lupto/ember-pcb/README.md

# EMBER PCB

This is the PCB for interfacing the EMBER macro with FPGA, power supplies, probing, and power measurement.
