lupto/ember-pcb/checklists/schematic-checklist-akashl.md

# Schematic review checklist

## General

* [x] CAD ERC 100% clean. If some errors are invalid due to toolchain quirks, each exception must be inspected and signed
off as invalid.
* [ ] Verify pin numbers of all schematic symbols against datasheet or external interface specification document (if not yet board proven).
  * [ ] Confirm FMC pins are done correctly
  * [ ] Confirm EMBER pins are oriented correctly
  * [ ] Confirm EMBER pins are mapped correctly to package
  * [ ] Confirm EMBER pins are mapped correctly to socket
  * [ ] Confirm all 256 EMBER pins are routed
* [x] Schematic symbol matches chosen component package
* [x] Thermal pads are connected to correct power rail (may not always be ground)
* [x] Debug interfaces are not power gated in sleep mode

## Passive components
* [ ] Power/voltage/tolerance ratings specified as required
  * [ ] Regulators work up to 500 mA
  * [ ] Switches are rated for up to 500 mA
  * [ ] Capacitors are rated for >3.3V
  * [ ] Ferrite beads are rated for >3.3V
* [x] Ceramic capacitors appropriately de-rated for C/V curve
  * [x] Using the setup from TCAM board
* [x] Polarized components specified in schematic if using electrolytic caps etc.

## Power supply

### System power input

* [x] Fusing and/or reverse voltage protection at system power inlet
* [x] Check total input capacitance and add inrush limiter if needed

### Regulators

* [x] Under/overvoltage protection configured correctly if used
  * [x] Implemented in regulators and at FPGA and EMBER macro
* [x] Verify estimated power usage per rail against regulator rating
* [x] Current-sense resistors on power rails after regulator output caps, not in switching loop
  * [x] Done on power measurement daughter board...
* [ ] Remote sense used on low voltage or high current rails
* [ ] Linear regulators and voltage reference ICs are stable with selected output cap ESR
* [ ] Confirm power rail sequencing against device datasheets

### Decoupling
* [x] Decoupling present for all ICs
* [ ] Decoupling meets/exceeds vendor recommendations if specified
* [x] Bulk decoupling present at PSU

### General
* [x] All power inputs fed by correct voltage
* [x] Check high-power discrete semiconductors and passives to confirm they can handle expected load
* [x] Analog rails filtered/isolated from digital circuitry as needed
  * [x] Separate planes should help

## Signals

### Digital

* [x] Signals are correct logic level for input pin
  * [x] All signals will be at FPGA setting
* [x] Pullups on all open-drain outputs
* [x] Pulldowns on all PECL outputs
* [x] Termination on all high-speed signals
* [x] AC coupling caps on gigabit transceivers
* [x] TX/RX paired correctly for UART, SPI, MGT, etc
* [x] Differential pair polarity / pairing correct
* [x] Active high/low enable signal polarity correct
* [x] I/O banking rules met on FPGAs etc
* [x] When using auto-sensing level shifters, ensure the intended receiver doesn't have a pullup/down

### Analog

* [x] RC time constant for attenuators sane given ADC sampling frequency
* [x] Verify frequency response of RF components across entire operating range. Don't assume a "1-100 MHz" amplifier has the
same gain across the whole range.
* [x] Verify polarity of op-amp feedback

### Clocks

* [x] All oscillators meet required jitter / frequency tolerance. Be extra cautious with MEMS oscillators as these tend to have higher jitter.
* [x] Correct load caps provided for discrete crystals
* [x] Crystals only used if IC has an integrated crystal driver
* [x] Banking / clock capable input rules met for clocks going to FPGAs
    * [x] Xilinx FPGAs: single ended clocks use _P half of differential pairs
    * [x] If possible, create dummy design with all clocks and other key signals and verify it P&R's properly

### Strap/init pins
* [x] Pullup/pulldowns on all signals that need defined state at boot
* [x] Strap pins connected to correct rail for desired state
  * [x] DIP switches are strapped to io_pwr
* [x] JTAG/ICSP connector provided for all programmable devices
* [x] Config/boot flash provided for all FPGAs or MPUs without internal flash
* [x] Reference resistors correct value and reference rail

### External interface protection

* [x] Power outputs (USB etc) current limited
  * [x] Regulators do this
* [x] ESD protection on data lines going off board
  * [x] Exist in EMBER and FPGA

### Debugging / reworkability

* [x] Use 0-ohm resistors vs direct hard-wiring for strap pins when possible
* [x] Provide multiple ground clips/points for scope probes
  * [x] Available on power header and analog header
* [x] Dedicated ground in close proximity to analog test points
* [x] Test points on all power rails
  * [x] Accessible through power headers
* [x] Test points on interesting signals which may need probing for bringup/debug
  * [x] Heartbeat
  * [x] All EMBER signals can be probed on bottom through socket

## Thermal

* [x] Power estimates for all large / high power ICs
  * [x] EMBER should never exceed 100 mA
* [x] Thermal calculations for all large / high power ICs
* [x] Specify heatsinks as needed
