lupto/ember-pcb/bom/EMBER_PCB.digikey.bom.xlsx

Country of Origin may be different at time of shipment.
The HTSUS and ECCN information shown is for informational purposes only and is not a representation or warranty as to the accuracy or reliability of these classifications. All information is provided "as is" and is subject to change without notice. Any use made of the information provided is without recourse to Digi-Key and at the user's risk.
Index | Manufacturer Part Number | Manufacturer Name | Description | Availability | Stock Status | Attrition % | Requested Quantity 1 | Pack Quantity 1 | Pack Type 1 | Digi-Key Part Number 1 | Unit Price 1 | Extended Price 1 | Minimum Order Quantity 1 | Customer Reference | Requested Part Number | Lead Weeks | Datasheet | Reference Designator | US Import Tariff | Note | Part Status | RoHS Status | ECCN | HTSUS | Country of Origin | Environmental Information | Original Part numbers | Image
1 | 28C0236-0JW-10 | Laird-Signal Integrity Products | FERRITE BEAD 998 OHM RADIAL 1LN | 133,536 | In Stock |  | 2 | 2 | Bulk | 240-2493-ND | 0.90000 | $1.80 | 1 |  | 240-2493-ND | 22 | https://media.digikey.com/pdf/Data%20Sheets/Laird%20Technologies/EMI_Filtering_and_RF_Inductors.pdf | FB1, FB2 | N/A |  | Active | ROHS3 Compliant | EAR99 | 8548.00.0000 | China |  | 240-2493-ND | https://media.digikey.com/photos/Steward%20Photos/28C0236-0JW-10.jpg
2 | 441-PRS21001-12 | Aries Electronics | CONN SOCKET PGA ZIF GOLD | 0 | Normally Stocking |  | 1 | 1 | Bulk | A318-ND | 164.97000 | $164.97 | 1 |  | A318-ND | 6 | https://www.arieselec.com/wp-content/uploads/2020/12/10004-pga-zif-test-and-burn-in-socket.pdf | U1 | N/A |  | Active | ROHS3 Compliant | EAR99 | 8536.69.4040 | United States | https://www.arieselec.com/wp-content/uploads/2020/05/RoHS-3-Declaration.pdf|https://www.arieselec.com/wp-content/uploads/2021/03/REACH-211-Compliance-Statement.pdf | A318-ND | https://media.digikey.com/photos/Aries/441-PRS21001-12.jpg
3 | LP5912-0.9DRVT | Texas Instruments | IC REG LINEAR 0.9V 500MA 6WSON | 708 | In Stock |  | 1 | 1 | Cut Tape (CT) | 296-44154-1-ND | 1.60000 | $1.60 | 1 |  | 296-44154-1-ND | 6 | http://www.ti.com/general/docs/suppproductinfo.tsp?distId=10 | U2 | N/A |  | Active | ROHS3 Compliant | EAR99 | 8542.39.0001 | Philippines |  | 296-44154-1-ND | https://media.digikey.com/Renders/Texas%20Instr%20Renders/296~4222173~DRV~6.jpg
4 | LP5912-1.1DRVT | Texas Instruments | IC REG LINEAR 1.1V 500MA 6WSON | 694 | In Stock |  | 1 | 1 | Cut Tape (CT) | 296-46644-1-ND | 1.60000 | $1.60 | 1 |  | 296-46644-1-ND | 12 | http://www.ti.com/general/docs/suppproductinfo.tsp?distId=10 | U3 | N/A |  | Active | ROHS3 Compliant | EAR99 | 8542.39.0001 | Philippines |  | 296-46644-1-ND | https://media.digikey.com/Renders/Texas%20Instr%20Renders/296~4222173~DRV~6.jpg
5 | LP5912-2.5DRVT | Texas Instruments | IC REG LINEAR 2.5V 500MA 6WSON | 266 | In Stock |  | 1 | 1 | Cut Tape (CT) | 296-52223-1-ND | 1.60000 | $1.60 | 1 |  | 296-52223-1-ND | 6 | http://www.ti.com/general/docs/suppproductinfo.tsp?distId=10 | U4 | May apply on shipments to the U.S. |  | Active | ROHS3 Compliant | EAR99 | 8542.39.0001 | China |  | 296-52223-1-ND | https://media.digikey.com/Renders/Texas%20Instr%20Renders/296~4222173~DRV~6.jpg
6 | LT Q39E-Q1OO-25-1 | OSRAM Opto (ams OSRAM) | LED GREEN DIFFUSED 0603 SMD | 17,350 | In Stock |  | 1 | 1 | Cut Tape (CT) | 475-3441-1-ND | 0.43000 | $0.43 | 1 |  | 475-3441-1-ND | 14 | https://dammedia.osram.info/media/resource/hires/osram-dam-2493475/LT%20Q39E.pdf | D1 | N/A |  | Active | ROHS3 Compliant | EAR99 | 8541.41.0000 | Taiwan |  | 475-3441-1-ND | https://media.digikey.com/Renders/Osram%20Opto%20Renders/LB-Q39E.jpg
7 | ASP-134602-01 | Samtec Inc. | CONN ARRAY PLUG 400POS SMD GOLD | 2,131 | In Stock |  | 1 | 1 | Cut Tape (CT) | 612-ASP-134602-01CT-ND | 29.88000 | $29.88 | 1 |  | 612-ASP-134602-01CT-ND | 11 | http://suddendocs.samtec.com/prints/asp-134602-01.pdf | J1 | N/A |  | Active | ROHS3 Compliant | EAR99 | 8536.69.4040 | Costa Rica |  | 612-ASP-134602-01CT-ND | https://media.digikey.com/Photos/Samtec%20Photos/ASP-134602-01_TOP.JPG
8 | 0732512200 | Molex | CONN SMA JACK R/A 50 OHM PCB | 26,937 | In Stock |  | 2 | 2 | Bulk | WM9352-ND | 6.88000 | $13.76 | 1 |  | WM9352-ND | 8 | https://www.molex.com/pdm_docs/sd/732512200_sd.pdf | J2, J5 | N/A |  | Active | ROHS3 Compliant | EAR99 | 8536.69.4010 | Taiwan | https://www.molex.com/datasheets/rohspdf/0732512200_rohs.pdf | WM9352-ND | https://media.digikey.com/Photos/Molex/0732512200.jpg
9 | PH2-12-UA | Adam Tech | CONN HEADER VERT 12POS 2.54MM | 19,939 | In Stock |  | 1 | 1 | Bag | 2057-PH2-12-UA-ND | 0.20000 | $0.20 | 1 |  | 2057-PH2-12-UA-ND | 10 | https://app.adam-tech.com/products/download/data_sheet/202065/ph2-xx-ua-data-sheet.pdf | J3 | N/A |  | Active | ROHS3 Compliant | EAR99 | 8536.69.4040 | Taiwan |  | 2057-PH2-12-UA-ND | https://media.digikey.com/Renders/Adam-Tech%20Renders/PH2-xx-UA.jpg
10 | PH1-07-UA | Adam Tech | CONN HEADER VERT 7POS 2.54MM | 23,741 | In Stock |  | 1 | 1 | Bag | 2057-PH1-07-UA-ND | 0.15000 | $0.15 | 1 |  | 2057-PH1-07-UA-ND | 10 | https://app.adam-tech.com/products/download/data_sheet/201605/ph1-xx-ua-data-sheet.pdf | J4 | N/A |  | Active | ROHS3 Compliant | EAR99 | 8536.69.4040 | Taiwan |  | 2057-PH1-07-UA-ND | https://media.digikey.com/Renders/Adam-Tech%20Renders/PH1-xx-UA.jpg
11 | AC0603JR-101KL | YAGEO | RESISTOR SMD | 58,836 | In Stock |  | 1 | 1 | Cut Tape (CT) | 13-AC0603JR-101KLCT-ND | 0.10000 | $0.10 | 1 |  | 13-AC0603JR-101KLCT-ND | 20 | https://www.yageo.com/upload/media/product/productsearch/datasheet/rchip/PYu-AC_51_RoHS_L_9.pdf | R1 | N/A |  | Active | ROHS3 Compliant | EAR99 | 8533.21.0030 | Taiwan |  | 13-AC0603JR-101KLCT-ND | https://media.digikey.com/Renders/Yageo%20Renders/AC-Series--SMD-Chip-Resistor.jpg
12 | RT0603DRE10100KL | YAGEO | CHIP RESISTOR THIN FLIM HIGH PRE | 9,069 | In Stock |  | 2 | 2 | Cut Tape (CT) | 13-RT0603DRE10100KLCT-ND | 0.11000 | $0.22 | 1 |  | 13-RT0603DRE10100KLCT-ND | 22 | https://www.yageo.com/upload/media/product/productsearch/datasheet/rchip/PYu-RT_1-to-0.01_RoHS_L_13.pdf | R2, R3 | N/A |  | Active | ROHS3 Compliant | EAR99 | 8533.21.0030 | Taiwan |  | 13-RT0603DRE10100KLCT-ND | https://media.digikey.com/Renders/Yageo%20Renders/RT-Series-Chip-Resistor.jpg
13 | PCM13SMTR | C&K | SWITCH SLIDE SP3T 300MA 6V | 8,339 | In Stock |  | 2 | 2 | Cut Tape (CT) | 401-2017-1-ND | 1.02000 | $2.04 | 1 |  | 401-2017-1-ND | 9 | https://www.ckswitches.com/media/1424/pcm.pdf | SW1, SW2 | May apply on shipments to the U.S. |  | Active | ROHS3 Compliant | EAR99 | 8536.50.9050 | China | https://www.ckswitches.com/media/3448/rohs-reach-compliance-certificate.pdf | 401-2017-1-ND | https://media.digikey.com/Photos/CK%20Comp%20Photos/PCM13SMTR.JPG
14 | A6S-2101-H | Omron Electronics Inc-EMC Div | SWITCH SLIDE DIP SPST 25MA 24V | 657 | In Stock |  | 1 | 1 | Bulk | Z5188-ND | 2.12000 | $2.12 | 1 |  | Z5188-ND | 27 | https://omronfs.omron.com/en_US/ecb/products/pdf/en-a6s.pdf | SW3 | May apply on shipments to the U.S. |  | Active | RoHS Compliant | EAR99 | 8536.50.9065 | China |  | Z5188-ND | https://media.digikey.com/Photos/Omron%20Elect%20Photos/A6S-2101-H.jpg
15 | T495B226K010ATE500 | KEMET | CAP TANT 22UF 10% 10V 1411 | 3,457 | In Stock |  | 4 | 4 | Cut Tape (CT) | 399-18339-1-ND | 1.57000 | $6.28 | 1 |  | 399-18339-1-ND | 44 | https://api.kemet.com/component-edge/download/datasheet/T495B226K010ATE500.pdf | C1, C3, C6, C8 | N/A |  | Active | ROHS3 Compliant | EAR99 | 8532.21.0050 | Mexico |  | 399-18339-1-ND | https://media.digikey.com/Photos/Kemet%20Photos/MFG_T495-Series.jpg
16 | C3225X7T2J104K160AE | TDK Corporation | CAP CER 0.1UF 630V X7T 1210 | 19,884 | In Stock |  | 4 | 4 | Cut Tape (CT) | 445-8907-1-ND | 0.65000 | $2.60 | 1 |  | 445-8907-1-ND | 28 | https://product.tdk.com/system/files/dam/doc/product/capacitor/ceramic/mlcc/catalog/mlcc_commercial_soft_en.pdf | C2, C5, C7, C10 | N/A |  | Active | ROHS3 Compliant | EAR99 | 8532.24.0020 | Japan | https://product.tdk.com/system/files/dam/doc/product/capacitor/ceramic/mlcc/rohs/mlccrohs_commercial_soft_en.pdf|https://product.tdk.com/en/environment/index.html | 445-8907-1-ND | https://media.digikey.com/Renders/TDK%20Renders/1210-(3225-Metric)-2,80mm-C-Series.jpg
17 | T494B106K025AT | KEMET | CAP TANT 10UF 10% 25V 1411 | 15,393 | In Stock |  | 2 | 2 | Cut Tape (CT) | 399-5126-1-ND | 1.48000 | $2.96 | 1 |  | 399-5126-1-ND | 56 | https://api.kemet.com/component-edge/download/datasheet/T494B106K025AT.pdf | C4, C9 | N/A |  | Active | ROHS3 Compliant | EAR99 | 8532.21.0050 | Mexico |  | 399-5126-1-ND | https://media.digikey.com/photos/Kemet%20Photos/T494B685K016AT.JPG
