lupto/ember-pcb/bom/Sierra-BOM-Sample-and-Demo.xls

This is a sample BOM for Sierra Circuits' online BOM pricing system. Please use this preferred format for your BOM that you upload.
Note: DNI applies to whole row. If only some specific locations of a given ITEM are not to be installed, please create two rows for that item and mark one as DNI.
BOM: <Board Name Here>
Assembly Part Number/Revision:
Customer / Company Name:
Item # | Quantity per board | Manufacturer Part # | Do Not Install | Reference designators | Vendor (optional) | Vendor Part Number (optional) | Value (optional) | Size / Footprint (optional) | Part description/ specs (optional, but recommended) | Manfacturer (optional)
1 | 2 | T520L337M2R5ATE025 |  | C12,C15 | Digi-Key | 399-5134-1-ND | 330uF | C6032 | CAP TANT 330UF 2.5V 20% SMD | Kemet
2 | 2 | T520L337M2R5ATE025 | DNI | C16,C17 | Digi-Key | 399-5134-1-ND | 330uF | C6032 | CAP TANT 330UF 2.5V 20% SMD | Kemet
3 | 2 | RMCF0805FT2K40 |  | R19, R24 | Digi-Key | 541-2.40KCCT-ND |  |  | RES SMD 2.4K OHM 1% 1/8W 0805 | Vishay Dale
4 | 5 | C3225X7R1E106M | DNI | C65,C66,C67,C68,C119 | Mouser | 810-C3225X7R1E106M | 10uF | C1210 (3225 metric) | CAP CER 10uF 25V X7R 20% SMD 1210 | TDK
5 | 3 | C0805C103J5GACTU |  | C149,C151,C161 | Digi-Key | 399-7992-1-ND | 10nF | C0805 | CAP CER 10000PF 50V C0G/NP0 0805 | KEMET
6 | 3 | GRM32ER61A476KE20L |  | C167, C169, C141 | Digi-Key | 490-3887-1-ND | 47uF | C1210 (3225 metric) | CAP CER 47UF 10V X5R 1210 | Taiyo Yuden
7 | 5 | C0805F104K5RACTU |  | C159, C152, C162, C166, C168 | Digi-Key | 478-1395-1-ND | 0.1uF | C0805 | CAP CER 0.1UF 50V X7R 0805 | Yageo
8 | 1 | T495D477M006ATE045 |  | C153 | Digi-Key | 399-5220-1-ND | 470uF | C7343-31 | CAP TANTALUM 470UF 6.3V 0.045ohm ESR SMD | Kemet
9 | 2 | B540C-13-F |  | D1,D2 | Digi-Key | B540C-FDICT-ND | 40V 5A | SMC | DIODE SCHOTTKY 40V 5A SMC | Diodes Inc
10 | 12 | APHCM2012CGCK-F01 |  | D3,D4,D5,D6,D7,D8,D9,D10,D11,D12,D13,D14 | Digi-Key | 754-1094-1-ND | LED | LED0805 | LED 2X1.25MM LOPRO 570NM GRN SMD | Kingbright Corp
11 | 1 | 2-5177986-5 |  | J5 | Digi-Key | A35089CT-ND | CON120 | conn_2x60_th | CONN PLUG 120 POS VERT DUAL | TE Connectivity
12 | 6 | 961103-6404-AR |  | J6,J7,J8,J9,J15,J17 | Digi-Key | 3M9448-ND | CON3 | HDR1X3_TH | CONN HEADER VERT SGL 3POS GOLD | 3M
13 | 1 | 961102-6404-AR |  | J16 | Digi-Key | 3M9447-ND | JUMPER | HDR1X2TH | CONN HEADER VERT SGL 2POS GOLD | 3M
14 | 10 | GBC36SFBN-M30 |  | JP1-JP10 | Digi-Key | S1043E-36-ND | 1 PIN HEADER | HDR1x1 | 1 PIN HEADER; BREAK FROM 36 PIN STANDARD HEADER STRIP | Sullins
15 | 14 | CRCW080510K0FKEA |  | R8, R14, R16, R17, R25, R26, R27, R28, R29, R30, R31, R33, R34, R35 | Mouser | 71-CRCW0805-10K-E3 |  |  | Thick Film Resistors - SMD 1/8watt 10Kohms 1% 100ppm | Vishay
16 | 3 | MSS1048-103MLB |  | L4,L6,L7 | COILCRAFT | MSS1048-103MLB | 10uH | ind_Mss1048 | INDUCTOR POWER 10UH 4.0A SMD 26mOHM | COILCRAFT
17 | 1 | SRR1260-120M |  | L5 | Arrow | SRR1260-120M | 12uH | ind_Srr1260 | INDUCTOR POWER 12UH 5.0A SMD 23mOHM | BOURNS
18 | 1 | SRR6603-1R5ML |  | L8 | Digi-Key | SRR6603-1R5MLCT-ND | 1.5uH | ind_Srr6603 | INDUCTOR POWER 1.5UH 2.8A SMD 45mOHM | BOURNS
19 | 6 | ERJ-2GEJ271X |  | R1,R2,R3,R4,R5,R6 | Digi-Key | P270JCT-ND | 270R | R0402 | RES 270 OHM 1/10W 5% 0402 SMD | Panasonic
20 | 2 | ERJ-2GEJ331X |  | R7,R9 | Digi-Key | P330JCT-ND | 330 | R0402 | RES 330 OHM 1/10W 5% 0402 SMD | Panasonic
21 | 5 | ERJ-2GEJ472X |  | R10,R11,R21,R22,R23 | Digi-Key | P4.7KJCT-ND | 4.7K | R0402 | RES 4.7K OHM 1/10W 5% 0402 SMD | Panasonic
22 | 2 | ERJ-6ENF6192V |  | R15,R18 | Digi-Key | P61.9KCCT-ND | 61.9K | R0805 | RES 61.9K OHM 1/8W 1% 0805 SMD | Panasonic
23 | 1 | ERJ-6ENF1581V |  | X7 | Digi-Key | P1.58KCCT-ND | 1.58K | R0805 | RES 1.58K OHM 1/8W 1% 0805 SMD | Panasonic
24 | 1 | NVF2955T1G |  | Q1 | Digi-Key | NVF2955T1GOSCT-ND |  |  | MOSFET P-CH 60V 2.6A SOT223 | ON Semiconductor
25 | 1 | ERJ-6ENF2550V |  | R48 | Digi-Key | P255CCT-ND | 255 | R0805 | RES 255 OHM 1/8W 1% 0805 SMD | Panasonic
26 | 4 | ERJ-3GEY0R00V |  | R37,R45,R46,R47 | Digi-Key | P0.0GCT-ND | 0 | R0603 | RES ZERO OHM 1/10W 5% 0603 SMD | Panasonic
27 | 2 | SN74ALVC244NSR |  | U1,U7 | Digi-Key | 296-12863-1-ND | SN74ALVC244 | SOP-20 | IC BUFF/DVR TRI-ST OCTAL 20SOP | Texas Instruments
28 | 2 | LM22670TJE-ADJ/NOPB |  | U4,U5 | Digi-Key | LM22670TJE-ADJCT-ND | LM22670TJE-ADJ/NOPB | TO263-7 | IC REG SWITCH BUC 3A ADJ TO263-7 | Texas Instruments
29 | 1 | ERA-6AEB1402V |  | X2 | Digi-Key | P14KDACT-ND |  |  | RES SMD 14K OHM 0.1% 1/8W 0805 | Panasonic
END OF BOM
