lupto/ember-pcb/components/73251-2200.stp

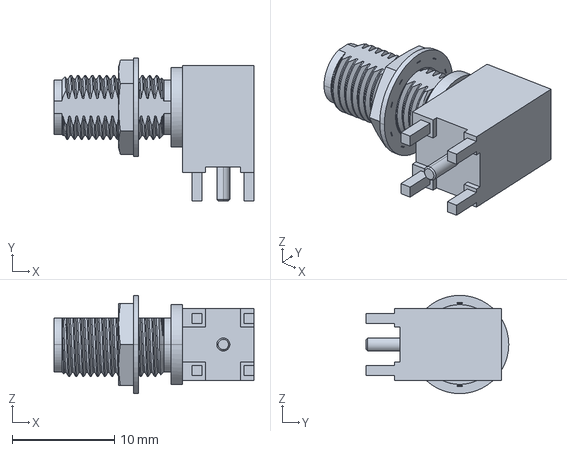
[picture p1: CAD file, 2022-12-14]
components/73251-2200.stp
19.5 x 13.9 x 9.60 mm
