lupto/ember-pcb/ember-pcb.kicad_pcb

## KiCad design ember-pcb.kicad_pcb (2022-12-09)

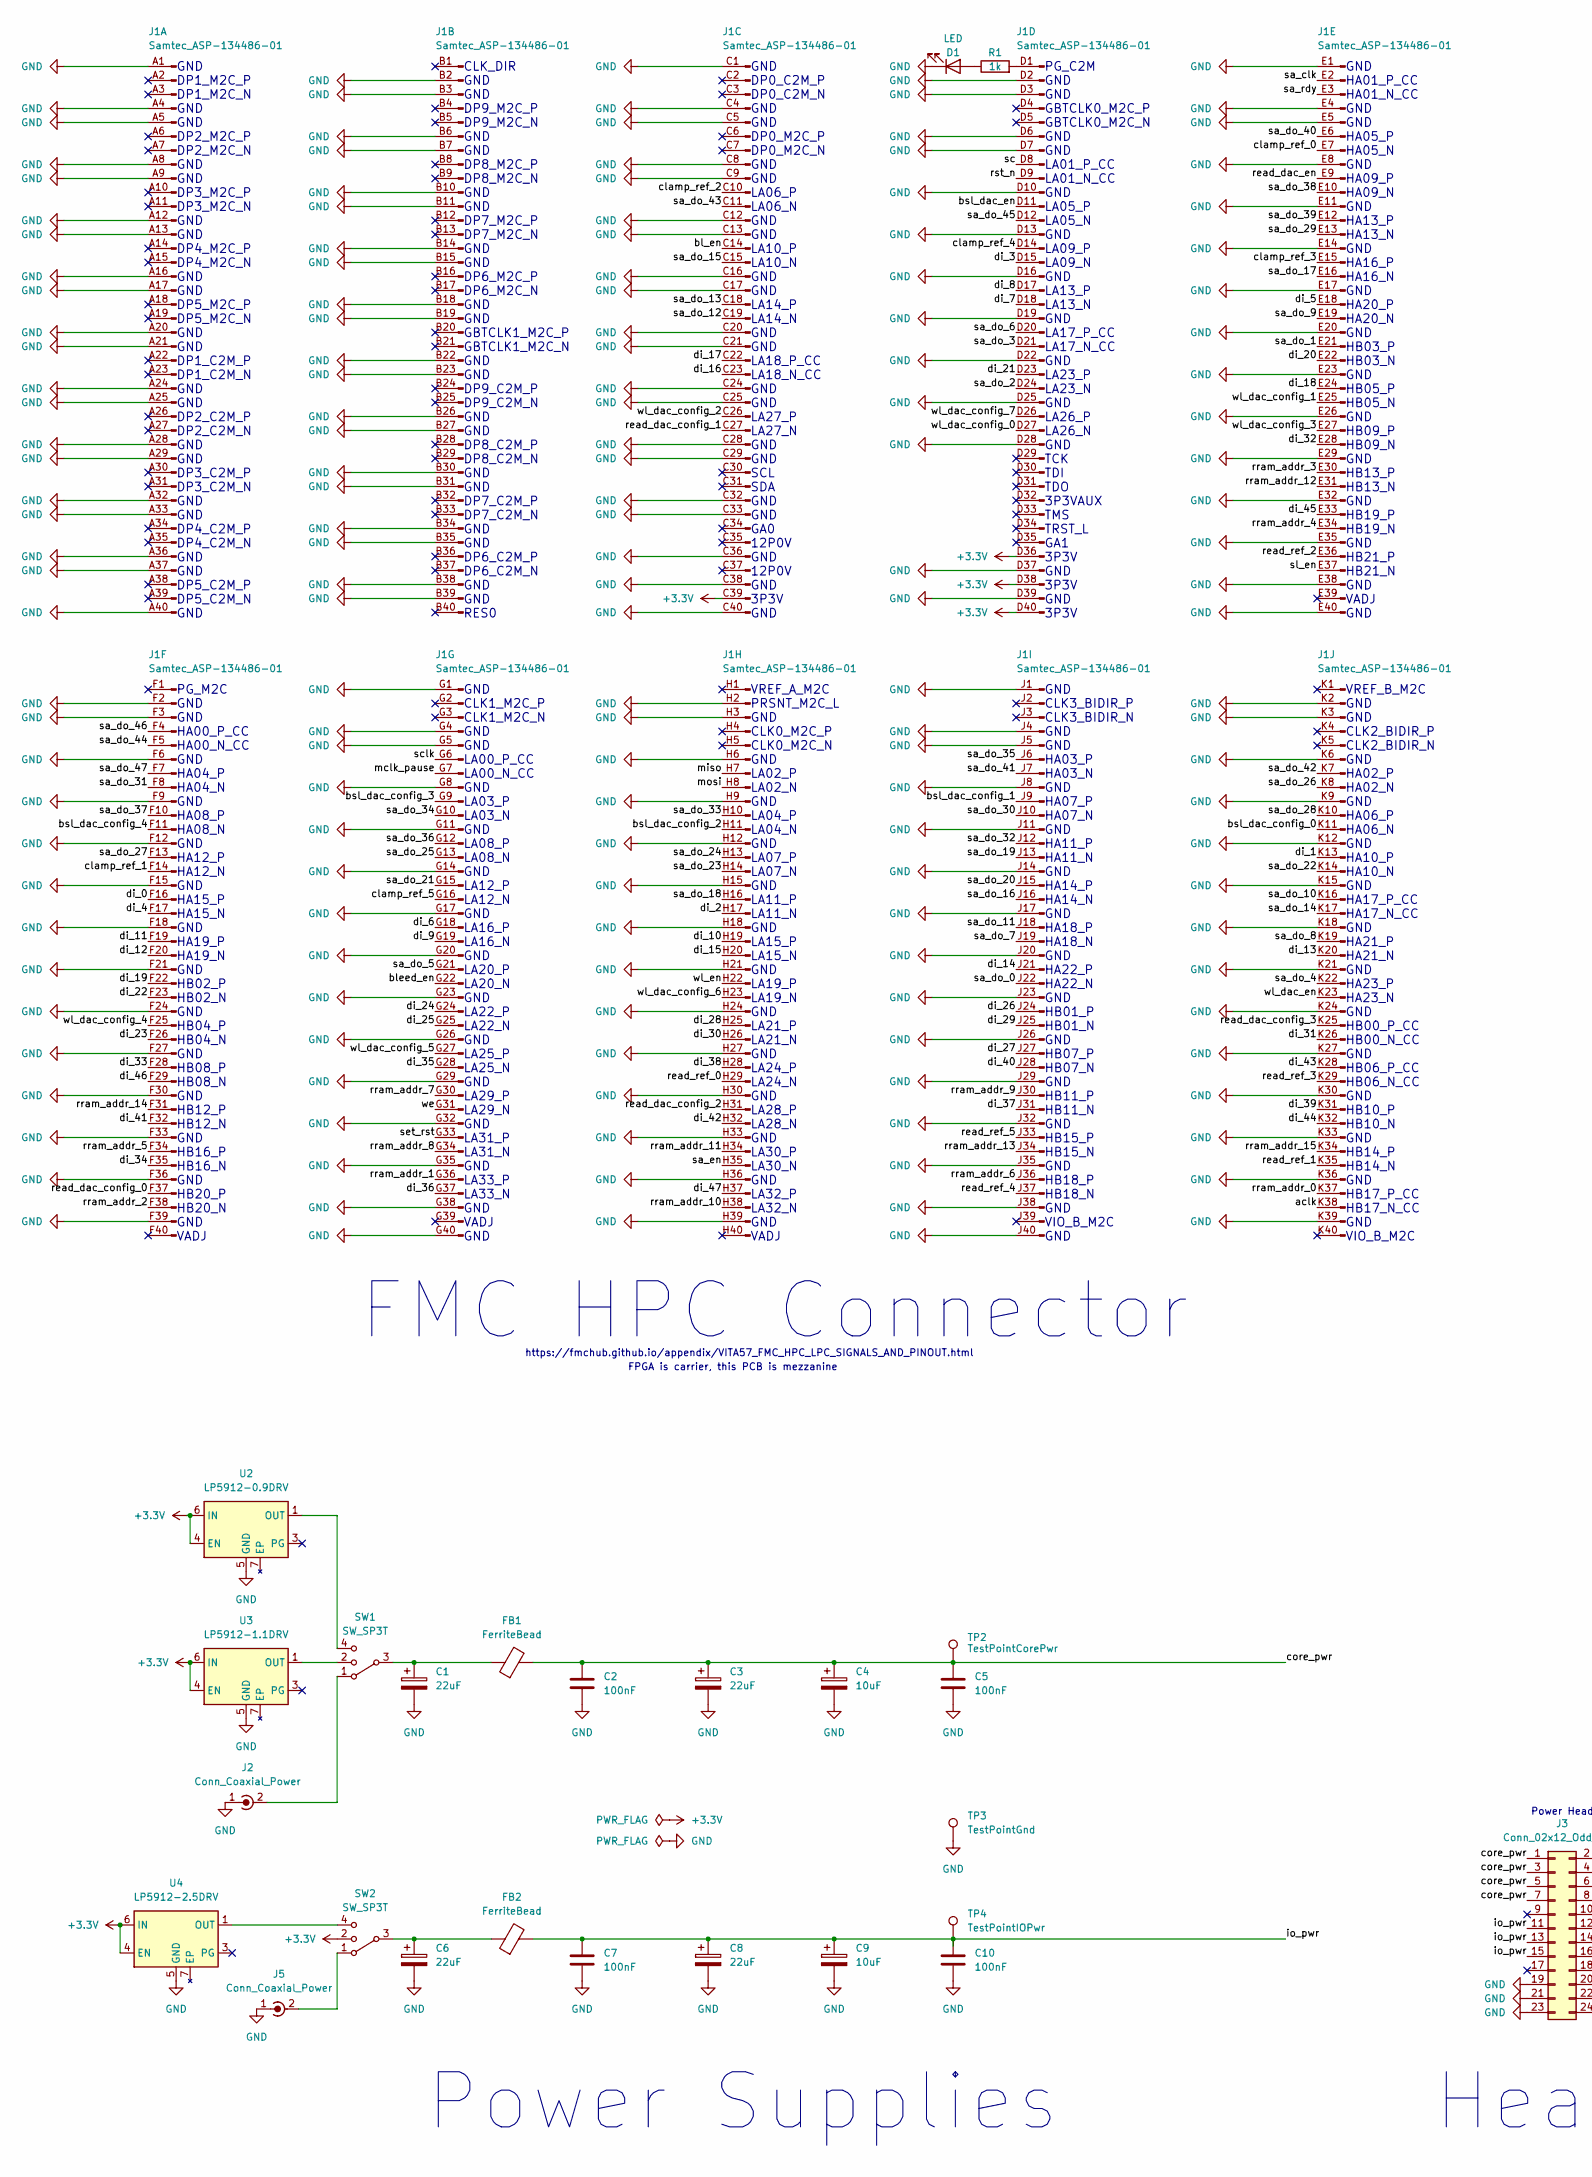
[picture p11: schematic ember-pcb.kicad_sch, EMBER PCB Schematic, part in row 1, column 1]

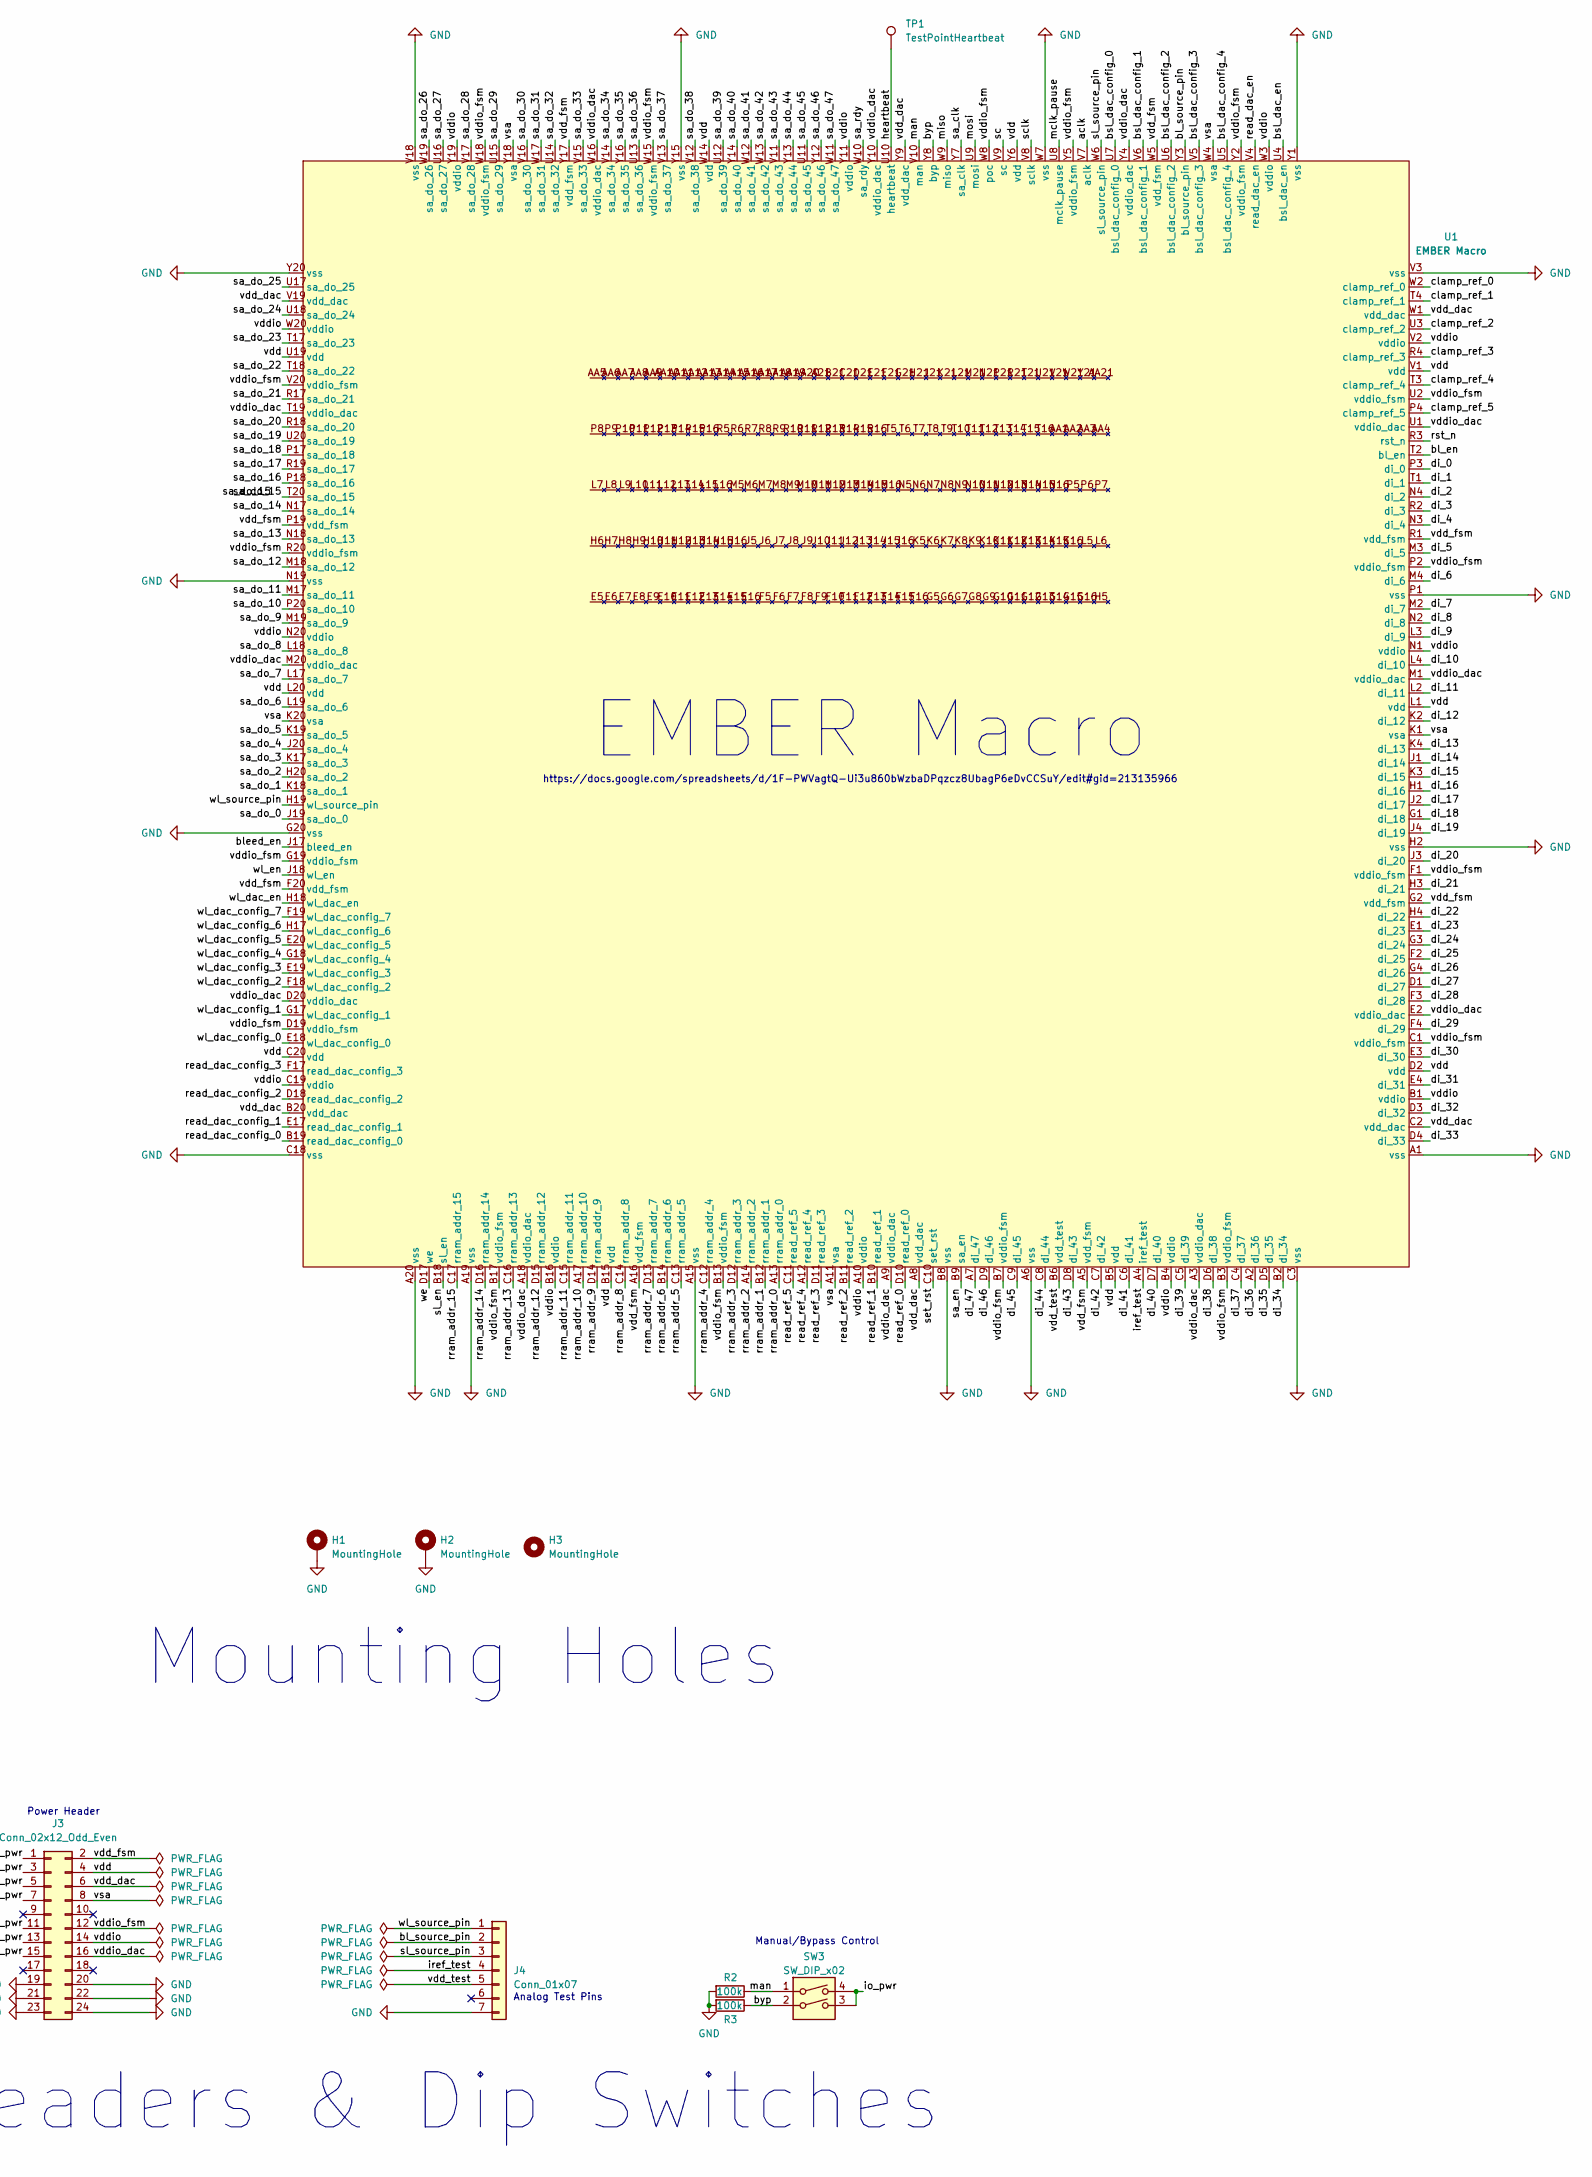
[picture p12: schematic ember-pcb.kicad_sch, EMBER PCB Schematic, part in row 1, column 2]

Parts:
C1, C3, C6, C8: 22uF; CP_Elec_3x5.3
C2, C5, C7, C10: 100nF; CP_Elec_3x5.3
C4, C9: 10uF; CP_Elec_3x5.3
D1: LED; LED_0603_1608Metric
FB1, FB2: FerriteBead; LairdTech_28C0236-0JW-10
H1, H2: MountingHole; MountingHole_2.5mm_Pad
H3: MountingHole; MountingHole_2.5mm
J1: Samtec_ASP-134486-01; Samtec_FMC_ASP-134486-01_10x40_P1.27mm_Vertical
J2, J5: Conn_Coaxial_Power; SMA_Samtec_SMA-J-P-X-ST-EM1_EdgeMount
J3: Conn_02x12_Odd_Even; PinHeader_2x12_P2.54mm_Vertical
J4: Conn_01x07; PinHeader_1x07_P2.54mm_Vertical
R1: 1k; R_0603_1608Metric
R2, R3: 100k; R_0603_1608Metric
SW1, SW2: SW_SP3T; SW_SP3T_PCM13
SW3: SW_DIP_x02; SW_DIP_SPSTx02_Slide_Omron_A6S-210x_W8.9mm_P2.54mm
TP1: TestPointHeartbeat; TestPoint_Pad_D1.0mm
TP2: TestPointCorePwr; TestPoint_Pad_D1.0mm
TP3: TestPointGnd; TestPoint_Pad_D1.0mm
TP4: TestPointIOPwr; TestPoint_Pad_D1.0mm
U1: EMBER Macro; ZIF-441_Aries
U2: LP5912-0.9DRV; WSON-6-1EP_2x2mm_P0.65mm_EP1x1.6mm_ThermalVias
U3: LP5912-1.1DRV; WSON-6-1EP_2x2mm_P0.65mm_EP1x1.6mm_ThermalVias
U4: LP5912-2.5DRV; WSON-6-1EP_2x2mm_P0.65mm_EP1x1.6mm_ThermalVias

Connections:
+3.3V: J1.C39 (Pin_39), J1.D36 (Pin_36), J1.D38 (Pin_38), J1.D40 (Pin_40), SW2.2, U2.4 (EN), U2.6 (IN), U3.4 (EN), U3.6 (IN), U4.4 (EN), U4.6 (IN)
/aclk: J1.K38 (Pin_38), U1.V7 (aclk)
/bl_en: J1.C14 (Pin_14), U1.T2 (bl_en)
/bl_source_pin: J4.2, U1.Y3 (bl_source_pin)
/bleed_en: J1.G22 (Pin_22), U1.J17 (bleed_en)
/bsl_dac_config_0: J1.K11 (Pin_11), U1.U7 (bsl_dac_config_0)
/bsl_dac_config_1: J1.J9 (Pin_9), U1.V6 (bsl_dac_config_1)
/bsl_dac_config_2: J1.H11 (Pin_11), U1.U6 (bsl_dac_config_2)
/bsl_dac_config_3: J1.G9 (Pin_9), U1.V5 (bsl_dac_config_3)
/bsl_dac_config_4: J1.F11 (Pin_11), U1.U5 (bsl_dac_config_4)
/bsl_dac_en: J1.D11 (Pin_11), U1.U4 (bsl_dac_en)
/byp: R3.1, SW3.2, U1.Y8 (byp)
/clamp_ref_0: J1.E7 (Pin_7), U1.W2 (clamp_ref_0)
/clamp_ref_1: J1.F14 (Pin_14), U1.T4 (clamp_ref_1)
/clamp_ref_2: J1.C10 (Pin_10), U1.U3 (clamp_ref_2)
/clamp_ref_3: J1.E15 (Pin_15), U1.R4 (clamp_ref_3)
/clamp_ref_4: J1.D14 (Pin_14), U1.T3 (clamp_ref_4)
/clamp_ref_5: J1.G16 (Pin_16), U1.P4 (clamp_ref_5)
/core_pwr: C2.1, C3.1, C4.1, C5.1, FB1.2, J3.1, J3.3, J3.5, J3.7, TP2.1
/di_0: J1.F16 (Pin_16), U1.P3 (di_0)
/di_1: J1.K13 (Pin_13), U1.T1 (di_1)
/di_2: J1.H17 (Pin_17), U1.N4 (di_2)
/di_3: J1.D15 (Pin_15), U1.R2 (di_3)
/di_4: J1.F17 (Pin_17), U1.N3 (di_4)
/di_5: J1.E18 (Pin_18), U1.M3 (di_5)
/di_6: J1.G18 (Pin_18), U1.M4 (di_6)
/di_7: J1.D18 (Pin_18), U1.M2 (di_7)
/di_8: J1.D17 (Pin_17), U1.N2 (di_8)
/di_9: J1.G19 (Pin_19), U1.L3 (di_9)
/di_10: J1.H19 (Pin_19), U1.L4 (di_10)
/di_11: J1.F19 (Pin_19), U1.L2 (di_11)
/di_12: J1.F20 (Pin_20), U1.K2 (di_12)
/di_13: J1.K20 (Pin_20), U1.K4 (di_13)
/di_14: J1.J21 (Pin_21), U1.J1 (di_14)
/di_15: J1.H20 (Pin_20), U1.K3 (di_15)
/di_16: J1.C23 (Pin_23), U1.H1 (di_16)
/di_17: J1.C22 (Pin_22), U1.J2 (di_17)
/di_18: J1.E24 (Pin_24), U1.G1 (di_18)
/di_19: J1.F22 (Pin_22), U1.J4 (di_19)
/di_20: J1.E22 (Pin_22), U1.J3 (di_20)
/di_21: J1.D23 (Pin_23), U1.H3 (di_21)
/di_22: J1.F23 (Pin_23), U1.H4 (di_22)
/di_23: J1.F26 (Pin_26), U1.E1 (di_23)
/di_24: J1.G24 (Pin_24), U1.G3 (di_24)
/di_25: J1.G25 (Pin_25), U1.F2 (di_25)
/di_26: J1.J24 (Pin_24), U1.G4 (di_26)
/di_27: J1.J27 (Pin_27), U1.D1 (di_27)
/di_28: J1.H25 (Pin_25), U1.F3 (di_28)
/di_29: J1.J25 (Pin_25), U1.F4 (di_29)
/di_30: J1.H26 (Pin_26), U1.E3 (di_30)
/di_31: J1.K26 (Pin_26), U1.E4 (di_31)
/di_32: J1.E28 (Pin_28), U1.D3 (di_32)
/di_33: J1.F28 (Pin_28), U1.D4 (di_33)
/di_34: J1.F35 (Pin_35), U1.B2 (di_34)
/di_35: J1.G28 (Pin_28), U1.D5 (di_35)
/di_36: J1.G37 (Pin_37), U1.A2 (di_36)
/di_37: J1.J31 (Pin_31), U1.C4 (di_37)
/di_38: J1.H28 (Pin_28), U1.D6 (di_38)
/di_39: J1.K31 (Pin_31), U1.C5 (di_39)
/di_40: J1.J28 (Pin_28), U1.D7 (di_40)
/di_41: J1.F32 (Pin_32), U1.C6 (di_41)
/di_42: J1.H32 (Pin_32), U1.C7 (di_42)
/di_43: J1.K28 (Pin_28), U1.D8 (di_43)
/di_44: J1.K32 (Pin_32), U1.C8 (di_44)
/di_45: J1.E33 (Pin_33), U1.C9 (di_45)
/di_46: J1.F29 (Pin_29), U1.D9 (di_46)
/di_47: J1.H37 (Pin_37), U1.A7 (di_47)
/heartbeat: TP1.1, U1.U10 (heartbeat)
/io_pwr: C7.1, C8.1, C9.1, C10.1, FB2.2, J3.11, J3.13, J3.15, SW3.3, SW3.4, TP4.1
/iref_test: J4.4, U1.A4 (iref_test)
/man: R2.1, SW3.1, U1.V10 (man)
/mclk_pause: J1.G7 (Pin_7), U1.U8 (mclk_pause)
/miso: J1.H7 (Pin_7), U1.W9 (miso)
/mosi: J1.H8 (Pin_8), U1.U9 (mosi)
/read_dac_config_0: J1.F37 (Pin_37), U1.B19 (read_dac_config_0)
/read_dac_config_1: J1.C27 (Pin_27), U1.E17 (read_dac_config_1)
/read_dac_config_2: J1.H31 (Pin_31), U1.D18 (read_dac_config_2)
/read_dac_config_3: J1.K25 (Pin_25), U1.F17 (read_dac_config_3)
/read_dac_en: J1.E9 (Pin_9), U1.V4 (read_dac_en)
/read_ref_0: J1.H29 (Pin_29), U1.D10 (read_ref_0)
/read_ref_1: J1.K35 (Pin_35), U1.B10 (read_ref_1)
/read_ref_2: J1.E36 (Pin_36), U1.B11 (read_ref_2)
/read_ref_3: J1.K29 (Pin_29), U1.D11 (read_ref_3)
/read_ref_4: J1.J37 (Pin_37), U1.A12 (read_ref_4)
/read_ref_5: J1.J33 (Pin_33), U1.C11 (read_ref_5)
/rram_addr_0: J1.K37 (Pin_37), U1.A13 (rram_addr_0)
/rram_addr_1: J1.G36 (Pin_36), U1.B12 (rram_addr_1)
/rram_addr_2: J1.F38 (Pin_38), U1.A14 (rram_addr_2)
/rram_addr_3: J1.E30 (Pin_30), U1.D12 (rram_addr_3)
/rram_addr_4: J1.E34 (Pin_34), U1.C12 (rram_addr_4)
/rram_addr_5: J1.F34 (Pin_34), U1.C13 (rram_addr_5)
/rram_addr_6: J1.J36 (Pin_36), U1.B14 (rram_addr_6)
/rram_addr_7: J1.G30 (Pin_30), U1.D13 (rram_addr_7)
/rram_addr_8: J1.G34 (Pin_34), U1.C14 (rram_addr_8)
/rram_addr_9: J1.J30 (Pin_30), U1.D14 (rram_addr_9)
/rram_addr_10: J1.H38 (Pin_38), U1.A17 (rram_addr_10)
/rram_addr_11: J1.H34 (Pin_34), U1.C15 (rram_addr_11)
/rram_addr_12: J1.E31 (Pin_31), U1.D15 (rram_addr_12)
/rram_addr_13: J1.J34 (Pin_34), U1.C16 (rram_addr_13)
/rram_addr_14: J1.F31 (Pin_31), U1.D16 (rram_addr_14)
/rram_addr_15: J1.K34 (Pin_34), U1.C17 (rram_addr_15)
/rst_n: J1.D9 (Pin_9), U1.R3 (rst_n)
/sa_clk: J1.E2 (Pin_2), U1.Y7 (sa_clk)
/sa_do_0: J1.J22 (Pin_22), U1.J19 (sa_do_0)
/sa_do_1: J1.E21 (Pin_21), U1.K18 (sa_do_1)
/sa_do_2: J1.D24 (Pin_24), U1.H20 (sa_do_2)
/sa_do_3: J1.D21 (Pin_21), U1.K17 (sa_do_3)
/sa_do_4: J1.K22 (Pin_22), U1.J20 (sa_do_4)
/sa_do_5: J1.G21 (Pin_21), U1.K19 (sa_do_5)
/sa_do_6: J1.D20 (Pin_20), U1.L19 (sa_do_6)
/sa_do_7: J1.J19 (Pin_19), U1.L17 (sa_do_7)
/sa_do_8: J1.K19 (Pin_19), U1.L18 (sa_do_8)
/sa_do_9: J1.E19 (Pin_19), U1.M19 (sa_do_9)
/sa_do_10: J1.K16 (Pin_16), U1.P20 (sa_do_10)
/sa_do_11: J1.J18 (Pin_18), U1.M17 (sa_do_11)
/sa_do_12: J1.C19 (Pin_19), U1.M18 (sa_do_12)
/sa_do_13: J1.C18 (Pin_18), U1.N18 (sa_do_13)
/sa_do_14: J1.K17 (Pin_17), U1.N17 (sa_do_14)
/sa_do_15: J1.C15 (Pin_15), U1.T20 (sa_do_15)
/sa_do_16: J1.J16 (Pin_16), U1.P18 (sa_do_16)
/sa_do_17: J1.E16 (Pin_16), U1.R19 (sa_do_17)
/sa_do_18: J1.H16 (Pin_16), U1.P17 (sa_do_18)
/sa_do_19: J1.J13 (Pin_13), U1.U20 (sa_do_19)
/sa_do_20: J1.J15 (Pin_15), U1.R18 (sa_do_20)
/sa_do_21: J1.G15 (Pin_15), U1.R17 (sa_do_21)
/sa_do_22: J1.K14 (Pin_14), U1.T18 (sa_do_22)
/sa_do_23: J1.H14 (Pin_14), U1.T17 (sa_do_23)
/sa_do_24: J1.H13 (Pin_13), U1.U18 (sa_do_24)
/sa_do_25: J1.G13 (Pin_13), U1.U17 (sa_do_25)
/sa_do_26: J1.K8 (Pin_8), U1.W19 (sa_do_26)
/sa_do_27: J1.F13 (Pin_13), U1.U16 (sa_do_27)
/sa_do_28: J1.K10 (Pin_10), U1.V17 (sa_do_28)
/sa_do_29: J1.E13 (Pin_13), U1.U15 (sa_do_29)
/sa_do_30: J1.J10 (Pin_10), U1.V16 (sa_do_30)
/sa_do_31: J1.F8 (Pin_8), U1.W17 (sa_do_31)
/sa_do_32: J1.J12 (Pin_12), U1.U14 (sa_do_32)
/sa_do_33: J1.H10 (Pin_10), U1.V15 (sa_do_33)
/sa_do_34: J1.G10 (Pin_10), U1.V14 (sa_do_34)
/sa_do_35: J1.J6 (Pin_6), U1.Y16 (sa_do_35)
/sa_do_36: J1.G12 (Pin_12), U1.U13 (sa_do_36)
/sa_do_37: J1.F10 (Pin_10), U1.V13 (sa_do_37)
/sa_do_38: J1.E10 (Pin_10), U1.V12 (sa_do_38)
/sa_do_39: J1.E12 (Pin_12), U1.U12 (sa_do_39)
/sa_do_40: J1.E6 (Pin_6), U1.Y14 (sa_do_40)
/sa_do_41: J1.J7 (Pin_7), U1.W12 (sa_do_41)
/sa_do_42: J1.K7 (Pin_7), U1.W13 (sa_do_42)
/sa_do_43: J1.C11 (Pin_11), U1.V11 (sa_do_43)
/sa_do_44: J1.F5 (Pin_5), U1.Y13 (sa_do_44)
/sa_do_45: J1.D12 (Pin_12), U1.U11 (sa_do_45)
/sa_do_46: J1.F4 (Pin_4), U1.Y12 (sa_do_46)
/sa_do_47: J1.F7 (Pin_7), U1.W11 (sa_do_47)
/sa_en: J1.H35 (Pin_35), U1.B9 (sa_en)
/sa_rdy: J1.E3 (Pin_3), U1.W10 (sa_rdy)
/sc: J1.D8 (Pin_8), U1.V9 (sc)
/sclk: J1.G6 (Pin_6), U1.V8 (sclk)
/set_rst: J1.G33 (Pin_33), U1.C10 (set_rst)
/sl_en: J1.E37 (Pin_37), U1.B18 (sl_en)
/sl_source_pin: J4.3, U1.W6 (sl_source_pin)
/vdd: J3.4, U1.B5 (vdd), U1.B15 (vdd), U1.C20 (vdd), U1.D2 (vdd), U1.L1 (vdd), U1.L20 (vdd), U1.U19 (vdd), U1.V1 (vdd), U1.W14 (vdd), U1.Y6 (vdd)
/vdd_dac: J3.6, U1.A8 (vdd_dac), U1.B20 (vdd_dac), U1.C2 (vdd_dac), U1.V19 (vdd_dac), U1.W1 (vdd_dac), U1.Y9 (vdd_dac)
/vdd_fsm: J3.2, U1.A5 (vdd_fsm), U1.A16 (vdd_fsm), U1.F20 (vdd_fsm), U1.G2 (vdd_fsm), U1.P19 (vdd_fsm), U1.R1 (vdd_fsm), U1.W5 (vdd_fsm), U1.Y17 (vdd_fsm)
/vdd_test: J4.5, U1.B6 (vdd_test)
/vddio: J3.14, U1.A10 (vddio), U1.B1 (vddio), U1.B4 (vddio), U1.B16 (vddio), U1.C19 (vddio), U1.N1 (vddio), U1.N20 (vddio), U1.V2 (vddio), U1.W3 (vddio), U1.W20 (vddio), U1.Y11 (vddio), U1.Y19 (vddio)
/vddio_dac: J3.16, U1.A3 (vddio_dac), U1.A9 (vddio_dac), U1.A18 (vddio_dac), U1.D20 (vddio_dac), U1.E2 (vddio_dac), U1.M1 (vddio_dac), U1.M20 (vddio_dac), U1.T19 (vddio_dac), U1.U1 (vddio_dac), U1.W16 (vddio_dac), U1.Y4 (vddio_dac), U1.Y10 (vddio_dac)
/vddio_fsm: J3.12, U1.B3 (vddio_fsm), U1.B7 (vddio_fsm), U1.B13 (vddio_fsm), U1.B17 (vddio_fsm), U1.C1 (vddio_fsm), U1.D19 (vddio_fsm), U1.F1 (vddio_fsm), U1.G19 (vddio_fsm), U1.P2 (vddio_fsm), U1.R20 (vddio_fsm), U1.U2 (vddio_fsm), U1.V20 (vddio_fsm), U1.W8 (poc), U1.W15 (vddio_fsm), U1.W18 (vddio_fsm), U1.Y2 (vddio_fsm), U1.Y5 (vddio_fsm)
/vsa: J3.8, U1.A11 (vsa), U1.K1 (vsa), U1.K20 (vsa), U1.W4 (vsa), U1.Y18 (vsa)
/we: J1.G31 (Pin_31), U1.D17 (we)
/wl_dac_config_0: J1.D27 (Pin_27), U1.E18 (wl_dac_config_0)
/wl_dac_config_1: J1.E25 (Pin_25), U1.G17 (wl_dac_config_1)
/wl_dac_config_2: J1.C26 (Pin_26), U1.F18 (wl_dac_config_2)
/wl_dac_config_3: J1.E27 (Pin_27), U1.E19 (wl_dac_config_3)
/wl_dac_config_4: J1.F25 (Pin_25), U1.G18 (wl_dac_config_4)
/wl_dac_config_5: J1.G27 (Pin_27), U1.E20 (wl_dac_config_5)
/wl_dac_config_6: J1.H23 (Pin_23), U1.H17 (wl_dac_config_6)
/wl_dac_config_7: J1.D26 (Pin_26), U1.F19 (wl_dac_config_7)
/wl_dac_en: J1.K23 (Pin_23), U1.H18 (wl_dac_en)
/wl_en: J1.H22 (Pin_22), U1.J18 (wl_en)
/wl_source_pin: J4.1, U1.H19 (wl_source_pin)
GND: C1.2, C2.2, C3.2, C4.2, C5.2, C6.2, C7.2, C8.2, C9.2, C10.2, D1.1 (K), H1.1, H2.1, J1.A1 (Pin_1), J1.A4 (Pin_4), J1.A5 (Pin_5), J1.A8 (Pin_8), J1.A9 (Pin_9), J1.A12 (Pin_12), J1.A13 (Pin_13), J1.A16 (Pin_16), J1.A17 (Pin_17), J1.A20 (Pin_20), J1.A21 (Pin_21), J1.A24 (Pin_24), J1.A25 (Pin_25), J1.A28 (Pin_28), J1.A29 (Pin_29), J1.A32 (Pin_32), J1.A33 (Pin_33), J1.A36 (Pin_36), J1.A37 (Pin_37), J1.A40 (Pin_40), J1.B2 (Pin_2), J1.B3 (Pin_3), J1.B6 (Pin_6), J1.B7 (Pin_7), J1.B10 (Pin_10), J1.B11 (Pin_11), J1.B14 (Pin_14), J1.B15 (Pin_15), J1.B18 (Pin_18), J1.B19 (Pin_19), J1.B22 (Pin_22), J1.B23 (Pin_23), J1.B26 (Pin_26), J1.B27 (Pin_27), J1.B30 (Pin_30), J1.B31 (Pin_31), J1.B34 (Pin_34), J1.B35 (Pin_35), J1.B38 (Pin_38), J1.B39 (Pin_39), J1.C1 (Pin_1), J1.C4 (Pin_4), J1.C5 (Pin_5), J1.C8 (Pin_8), J1.C9 (Pin_9), J1.C12 (Pin_12), J1.C13 (Pin_13), J1.C16 (Pin_16), J1.C17 (Pin_17), J1.C20 (Pin_20), J1.C21 (Pin_21), J1.C24 (Pin_24), J1.C25 (Pin_25), J1.C28 (Pin_28), J1.C29 (Pin_29), J1.C32 (Pin_32), J1.C33 (Pin_33), J1.C36 (Pin_36), J1.C38 (Pin_38), J1.C40 (Pin_40), J1.D2 (Pin_2), J1.D3 (Pin_3), J1.D6 (Pin_6), J1.D7 (Pin_7), J1.D10 (Pin_10), J1.D13 (Pin_13), J1.D16 (Pin_16), J1.D19 (Pin_19), J1.D22 (Pin_22), J1.D25 (Pin_25), J1.D28 (Pin_28), J1.D37 (Pin_37), J1.D39 (Pin_39), J1.E1 (Pin_1), J1.E4 (Pin_4), J1.E5 (Pin_5), J1.E8 (Pin_8), J1.E11 (Pin_11), J1.E14 (Pin_14), J1.E17 (Pin_17), J1.E20 (Pin_20), J1.E23 (Pin_23), J1.E26 (Pin_26), J1.E29 (Pin_29), J1.E32 (Pin_32), J1.E35 (Pin_35), J1.E38 (Pin_38), J1.E40 (Pin_40), J1.F2 (Pin_2), J1.F3 (Pin_3), J1.F6 (Pin_6), J1.F9 (Pin_9), J1.F12 (Pin_12), J1.F15 (Pin_15), J1.F18 (Pin_18), J1.F21 (Pin_21), J1.F24 (Pin_24), J1.F27 (Pin_27), J1.F30 (Pin_30), J1.F33 (Pin_33), J1.F36 (Pin_36), J1.F39 (Pin_39), J1.G1 (Pin_1), J1.G4 (Pin_4), J1.G5 (Pin_5), J1.G8 (Pin_8), J1.G11 (Pin_11), J1.G14 (Pin_14), J1.G17 (Pin_17), J1.G20 (Pin_20), J1.G23 (Pin_23), J1.G26 (Pin_26), J1.G29 (Pin_29), J1.G32 (Pin_32), J1.G35 (Pin_35), J1.G38 (Pin_38), J1.G40 (Pin_40), J1.H2 (Pin_2), J1.H3 (Pin_3), J1.H6 (Pin_6), J1.H9 (Pin_9), J1.H12 (Pin_12), J1.H15 (Pin_15), J1.H18 (Pin_18), J1.H21 (Pin_21), J1.H24 (Pin_24), J1.H27 (Pin_27), J1.H30 (Pin_30), J1.H33 (Pin_33), J1.H36 (Pin_36), J1.H39 (Pin_39), J1.J1 (Pin_1), J1.J4 (Pin_4), J1.J5 (Pin_5), J1.J8 (Pin_8), J1.J11 (Pin_11), J1.J14 (Pin_14), J1.J17 (Pin_17), J1.J20 (Pin_20), J1.J23 (Pin_23), J1.J26 (Pin_26), J1.J29 (Pin_29), J1.J32 (Pin_32), J1.J35 (Pin_35), J1.J38 (Pin_38), J1.J40 (Pin_40), J1.K2 (Pin_2), J1.K3 (Pin_3), J1.K6 (Pin_6), J1.K9 (Pin_9), J1.K12 (Pin_12), J1.K15 (Pin_15), J1.K18 (Pin_18), J1.K21 (Pin_21), J1.K24 (Pin_24), J1.K27 (Pin_27), J1.K30 (Pin_30), J1.K33 (Pin_33), J1.K36 (Pin_36), J1.K39 (Pin_39), J2.1 (In), J3.19, J3.20, J3.21, J3.22, J3.23, J3.24, J4.7, J5.1 (In), R2.2, R3.2, TP3.1, U1.A1 (vss), U1.A6 (vss), U1.A15 (vss), U1.A19 (vss), U1.A20 (vss), U1.B8 (vss), U1.C3 (vss), U1.C18 (vss), U1.G20 (vss), U1.H2 (vss), U1.N19 (vss), U1.P1 (vss), U1.V3 (vss), U1.V18 (vss), U1.W7 (vss), U1.Y1 (vss), U1.Y15 (vss), U1.Y20 (vss), U2.5 (GND), U3.5 (GND), U4.5 (GND)
unnamed: C1.1, FB1.1, SW1.3
unnamed: C6.1, FB2.1, SW2.3
unnamed: D1.2 (A), R1.1
unnamed: J1.D1 (Pin_1), R1.2
unnamed: J2.2 (Ext), SW1.1
unnamed: J5.2 (Ext), SW2.1
unnamed: SW1.2, U3.1 (OUT)
unnamed: SW1.4, U2.1 (OUT)
unnamed: SW2.4, U4.1 (OUT)

Notes on the sheet:
Manual/Bypass Control
VREF_B_M2C GND GND CLK2_BIDIR_P CLK2_BIDIR_N GND HA02_P HA02_N GND HA06_P HA06_N GND HA10_P HA10_N GND HA17_P_CC HA17_N_CC GND HA21_P HA21_N GND HA23_P HA23_N GND HB00_P_CC HB00_N_CC GND HB06_P_CC HB06_N_CC GND HB10_P HB10_N GND HB14_P HB14_N GND HB17_P_CC HB17_N_CC GND VIO_B_M2C
https://fmchub.github.io/appendix/VITA57_FMC_HPC_LPC_SIGNALS_AND_PINOUT.html
GND DP1_M2C_P DP1_M2C_N GND GND DP2_M2C_P DP2_M2C_N GND GND DP3_M2C_P DP3_M2C_N GND GND DP4_M2C_P DP4_M2C_N GND GND DP5_M2C_P DP5_M2C_N GND GND DP1_C2M_P DP1_C2M_N GND GND DP2_C2M_P DP2_C2M_N GND GND DP3_C2M_P DP3_C2M_N GND GND DP4_C2M_P DP4_C2M_N GND GND DP5_C2M_P DP5_C2M_N GND
VREF_A_M2C PRSNT_M2C_L GND CLK0_M2C_P CLK0_M2C_N GND LA02_P LA02_N GND LA04_P LA04_N GND LA07_P LA07_N GND LA11_P LA11_N GND LA15_P LA15_N GND LA19_P LA19_N GND LA21_P LA21_N GND LA24_P LA24_N GND LA28_P LA28_N GND LA30_P LA30_N GND LA32_P LA32_N GND VADJ
PG_M2C GND GND HA00_P_CC HA00_N_CC GND HA04_P HA04_N GND HA08_P HA08_N GND HA12_P HA12_N GND HA15_P HA15_N GND HA19_P HA19_N GND HB02_P HB02_N GND HB04_P HB04_N GND HB08_P HB08_N GND HB12_P HB12_N GND HB16_P HB16_N GND HB20_P HB20_N GND VADJ
https://docs.google.com/spreadsheets/d/1F-PWVagtQ-Ui3u860bWzbaDPqzcz8UbagP6eDvCCSuY/edit#gid=213135966
GND CLK3_BIDIR_P CLK3_BIDIR_N GND GND HA03_P HA03_N GND HA07_P HA07_N GND HA11_P HA11_N GND HA14_P HA14_N GND HA18_P HA18_N GND HA22_P HA22_N GND HB01_P HB01_N GND HB07_P HB07_N GND HB11_P HB11_N GND HB15_P HB15_N GND HB18_P HB18_N GND VIO_B_M2C GND
FMC HPC Connector
EMBER Macro
Mounting Holes
Power Supplies
Analog Test Pins
GND CLK1_M2C_P CLK1_M2C_N GND GND LA00_P_CC LA00_N_CC GND LA03_P LA03_N GND LA08_P LA08_N GND LA12_P LA12_N GND LA16_P LA16_N GND LA20_P LA20_N GND LA22_P LA22_N GND LA25_P LA25_N GND LA29_P LA29_N GND LA31_P LA31_N GND LA33_P LA33_N GND VADJ GND
FPGA is carrier, this PCB is mezzanine
GND HA01_P_CC HA01_N_CC GND GND HA05_P HA05_N GND HA09_P HA09_N GND HA13_P HA13_N GND HA16_P HA16_N GND HA20_P HA20_N GND HB03_P HB03_N GND HB05_P HB05_N GND HB09_P HB09_N GND HB13_P HB13_N GND HB19_P HB19_N GND HB21_P HB21_N GND VADJ GND
Power Header
PG_C2M GND GND GBTCLK0_M2C_P GBTCLK0_M2C_N GND GND LA01_P_CC LA01_N_CC GND LA05_P LA05_N GND LA09_P LA09_N GND LA13_P LA13_N GND LA17_P_CC LA17_N_CC GND LA23_P LA23_N GND LA26_P LA26_N GND TCK TDI TDO 3P3VAUX TMS TRST_L GA1 3P3V GND 3P3V GND 3P3V
CLK_DIR GND GND DP9_M2C_P DP9_M2C_N GND GND DP8_M2C_P DP8_M2C_N GND GND DP7_M2C_P DP7_M2C_N GND GND DP6_M2C_P DP6_M2C_N GND GND GBTCLK1_M2C_P GBTCLK1_M2C_N GND GND DP9_C2M_P DP9_C2M_N GND GND DP8_C2M_P DP8_C2M_N GND GND DP7_C2M_P DP7_C2M_N GND GND DP6_C2M_P DP6_C2M_N GND GND RES0
Headers & Dip Switches
GND DP0_C2M_P DP0_C2M_N GND GND DP0_M2C_P DP0_M2C_N GND GND LA06_P LA06_N GND GND LA10_P LA10_N GND GND LA14_P LA14_N GND GND LA18_P_CC LA18_N_CC GND GND LA27_P LA27_N GND GND SCL SDA GND GND GA0 12P0V GND 12P0V GND 3P3V GND

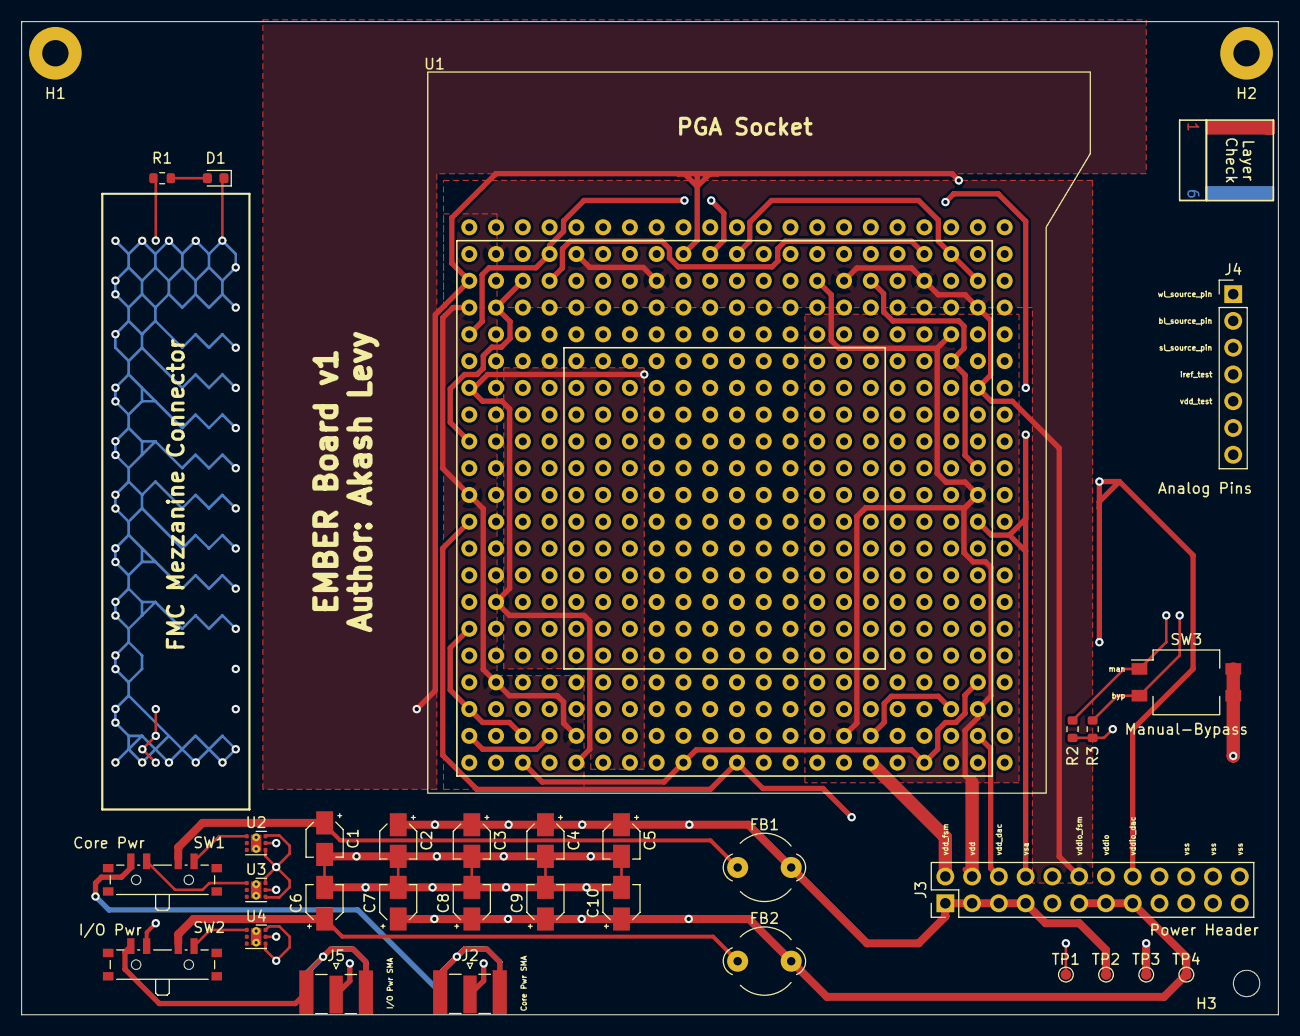
[picture p13: board ember-pcb.kicad_pcb from above]

Board: 6 copper layers, 119.3 x 94.2 mm, 34 parts (0 on the bottom side), 27 nets.
