lupto/ember-pcb/(commit log)

2022-12-09 6 layer
    [ember-pcb.kicad_pcb]
2022-12-10 12 layer board power routing done
2022-12-14 Getting more in shape
    [73251-2200.stp, ember-pcb.bom.csv, ember-pcb.bom.xls, ember-pcb.bom.xlsx, ember-pcb.csv, ember-pcb.kicad_sch, ember-pcb.new.bom.xlsx]
2022-12-14 Clean up
    [ember-pcb.bom.csv, ember-pcb.bom.xls, ember-pcb.bom.xlsx, ember-pcb.csv, ember-pcb.new.bom.xlsx]
2022-12-15 Refactor and clean
    [73251-2200.stp, BOM-Sample-and-Demo.xls, Sierra-BOM-Sample-and-Demo.xls]
2022-12-15 Update schematic-checklist-lupton.md
    Initial comments. Need to re-examine macro pin labels & how they map to sockets.
